directorBae/booth/Schematic_Neopixel_2025-10-20.pdf

A | A
B | B

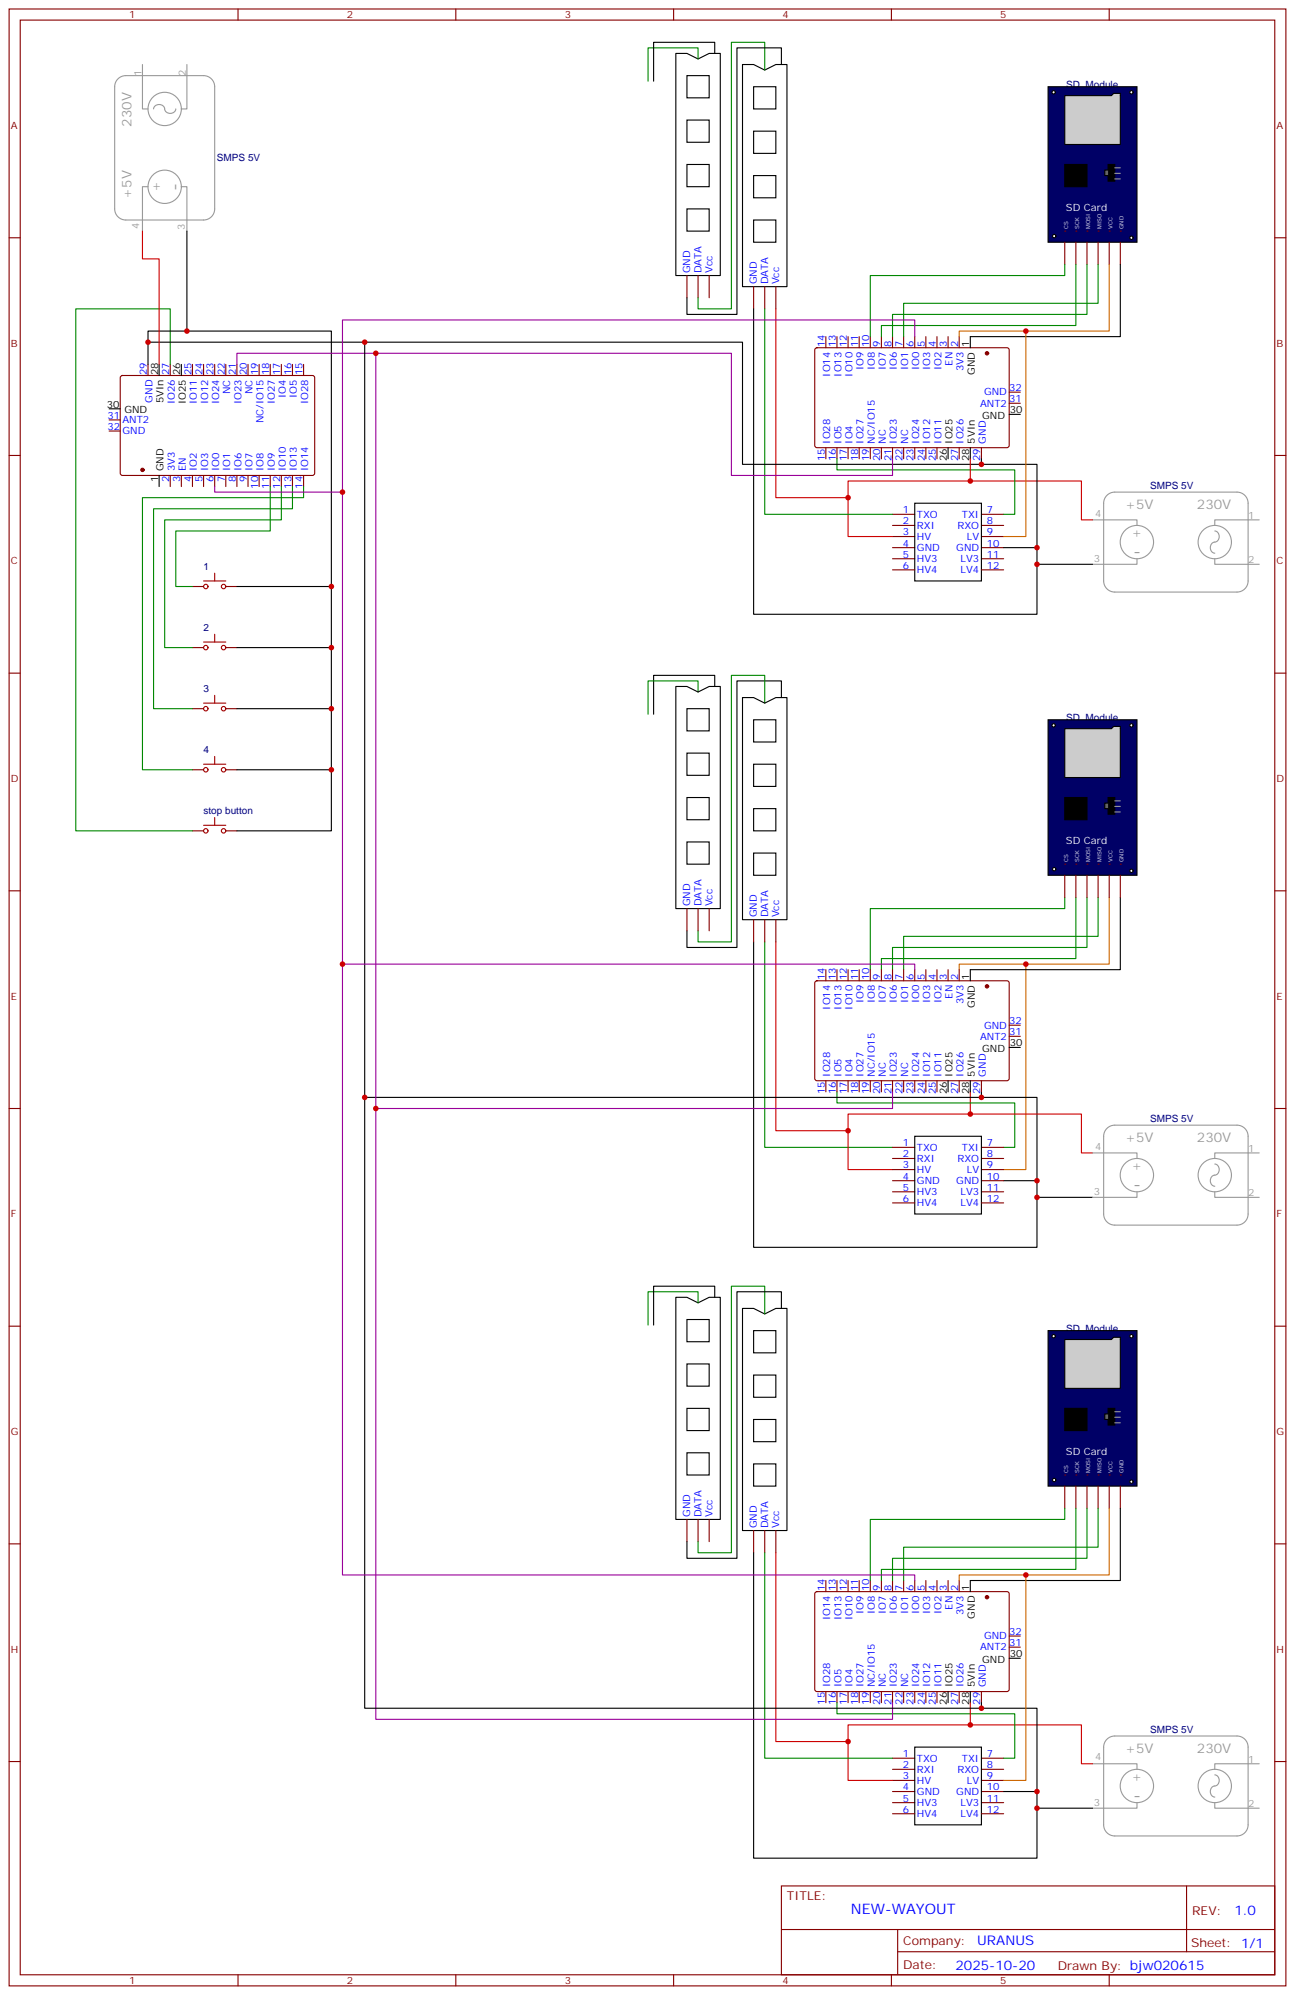
[picture p1: page 1]

IO14 14 IO5 16 IO4 17 IO27 18 NC/IO15 19 NC 20 IO23 21 NC 22 IO24 23 IO12 24 IO11 25 IO25 26 IO26 27 5VIn 28 GND 29 IO28 15
